nhat05027/BCNN-Verilog/Gowin/cnn_fpga/impl/gwsynthesis/cnn_fpga_syn_resource.html

# Hierarchy Module Resource

MODULE NAME | REG NUMBER | ALU NUMBER | LUT NUMBER | DSP NUMBER | BSRAM NUMBER | SSRAM NUMBER | ROM16 NUMBER
uart_controller (C:/Users/ADMIN/Desktop/HK242/DA1/cnnverilog/src/uart_controller.sv) | 30 | - | 242 | - | - | - | -
|--rpll (C:/Users/ADMIN/Desktop/HK242/DA1/cnnverilog/src/uart_controller.sv) | - | - | - | - | - | - | -
|--receiver (C:/Users/ADMIN/Desktop/HK242/DA1/cnnverilog/src/uart_controller.sv) | 38 | - | 59 | - | - | - | -
|--lcd (C:/Users/ADMIN/Desktop/HK242/DA1/cnnverilog/src/uart_controller.sv) | 60 | - | 120 | 1 | - | - | -
|--lcd_ram (C:/Users/ADMIN/Desktop/HK242/DA1/cnnverilog/src/uart_controller.sv) | - | - | - | - | 1 | - | -
|--cnn_ram (C:/Users/ADMIN/Desktop/HK242/DA1/cnnverilog/src/uart_controller.sv) | - | - | - | - | 1 | - | -
|--dut (C:/Users/ADMIN/Desktop/HK242/DA1/cnnverilog/src/uart_controller.sv) | 87 | 417 | 675 | 5 | - | - | -
|--DP (C:/Users/ADMIN/Desktop/HK242/DA1/cnnverilog/src/cnn.sv) | 16 | 144 | 23 | - | 6 | - | -
|--C (C:/Users/ADMIN/Desktop/HK242/DA1/cnnverilog/src/datapath.sv) | 6 | - | 158 | - | - | - | -
|--[0].F (C:/Users/ADMIN/Desktop/HK242/DA1/cnnverilog/src/conv.sv) | 11 | - | 4 | - | - | 3 | -
|--[1].F (C:/Users/ADMIN/Desktop/HK242/DA1/cnnverilog/src/conv.sv) | 8 | - | 1 | - | - | - | -
|--[2].F (C:/Users/ADMIN/Desktop/HK242/DA1/cnnverilog/src/conv.sv) | 8 | - | 1 | - | - | - | -
|--[3].F (C:/Users/ADMIN/Desktop/HK242/DA1/cnnverilog/src/conv.sv) | 8 | - | 1 | - | - | - | -
|--[4].F (C:/Users/ADMIN/Desktop/HK242/DA1/cnnverilog/src/conv.sv) | 8 | - | 1 | - | - | - | -
|--[5].F (C:/Users/ADMIN/Desktop/HK242/DA1/cnnverilog/src/conv.sv) | 8 | - | 1 | - | - | - | -
|--[6].F (C:/Users/ADMIN/Desktop/HK242/DA1/cnnverilog/src/conv.sv) | 8 | - | 1 | - | - | - | -
|--[7].F (C:/Users/ADMIN/Desktop/HK242/DA1/cnnverilog/src/conv.sv) | 8 | - | 1 | - | - | - | -
|--[8].F (C:/Users/ADMIN/Desktop/HK242/DA1/cnnverilog/src/conv.sv) | 8 | - | 1 | - | - | - | -
|--[9].F (C:/Users/ADMIN/Desktop/HK242/DA1/cnnverilog/src/conv.sv) | 8 | - | 1 | - | - | - | -
|--[10].F (C:/Users/ADMIN/Desktop/HK242/DA1/cnnverilog/src/conv.sv) | 8 | - | 1 | - | - | - | -
|--[11].F (C:/Users/ADMIN/Desktop/HK242/DA1/cnnverilog/src/conv.sv) | 8 | - | 1 | - | - | - | -
|--B (C:/Users/ADMIN/Desktop/HK242/DA1/cnnverilog/src/datapath.sv) | 1 | 12 | - | 1 | - | - | -
|--M (C:/Users/ADMIN/Desktop/HK242/DA1/cnnverilog/src/datapath.sv) | 14 | 12 | 2 | - | - | - | -
|--R (C:/Users/ADMIN/Desktop/HK242/DA1/cnnverilog/src/datapath.sv) | - | - | - | - | 12 | - | -
|--FC (C:/Users/ADMIN/Desktop/HK242/DA1/cnnverilog/src/datapath.sv) | 168 | 861 | 540 | 7 | - | - | -
|--b7s (C:/Users/ADMIN/Desktop/HK242/DA1/cnnverilog/src/uart_controller.sv) | - | - | 7 | - | - | - | -
