nhat05027/BCNN-Verilog/Tensorflow/model_1.png

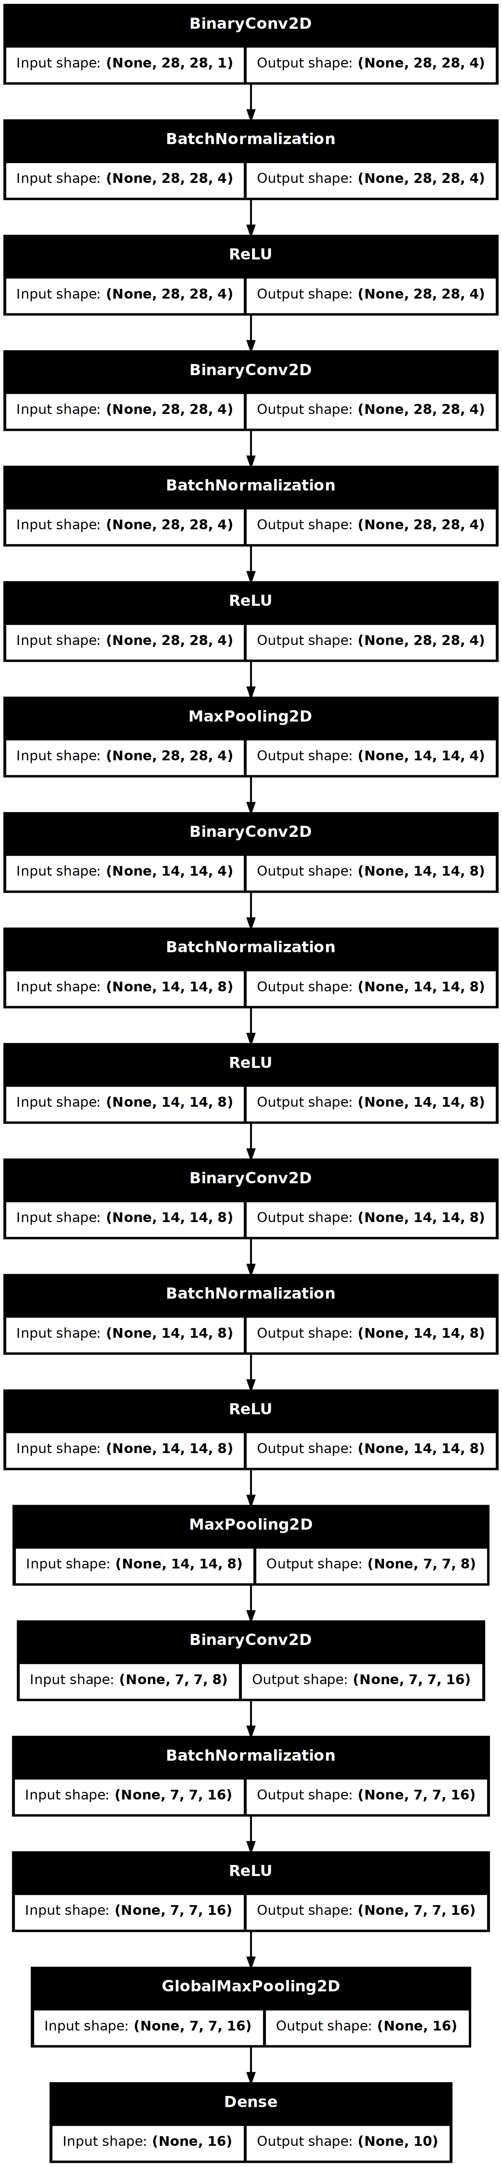
Tensorflow/model_1.png
