nhat05027/BCNN-Verilog/(list of files, cad)

Other CAD files:
Source/sim/work/@s@i@p@o110/verilog.psm
Source/sim/work/@s@i@p@o19/verilog.psm
Source/sim/work/bnorm/verilog.psm
Source/sim/work/bnorm_tb/verilog.psm
Source/sim/work/bsram/verilog.psm
Source/sim/work/cnn/verilog.psm
Source/sim/work/conv/verilog.psm
Source/sim/work/datapath/verilog.psm
Source/sim/work/fullyconnect/verilog.psm
Source/sim/work/maxpool/verilog.psm
Source/sim/work/maxpool_tb/verilog.psm
Source/sim/work/tb_@fully@connect/verilog.psm
Source/sim/work/tb_cnn/verilog.psm
Source/sim/work/tb_cnn_data/verilog.psm
Source/sim/work/tb_conv/verilog.psm
