nhat05027/BCNN-Verilog/Tensorflow/riscv_tf/main.cpp

#include <stdio.h>
#include <math.h>

// ---------------------------------------------------------------
// Model parameters (weights/biases exported from Keras)
// ---------------------------------------------------------------
// Conv2D 4 filters (3x3x1) -> shape [3,3,1,4]
static const float conv1_weights[] = { -0.07325755, 1.1865675, -0.17460105, 0.40934697, 0.0067278566, 0.8636283, 0.45649847, 0.5782181, -0.2517621, 0.88706565, 0.5372558, 0.603698, -0.2393193, -0.22988063, -0.917086, 0.9243598, -0.1709271, 0.16026053, -1.2387735, 0.6723341, -0.2249587, 1.0668899, -0.9474671, 0.26665154, -0.3354636, -0.47381037, 0.75013095, 1.6653285, -0.1717411, -0.0008511407, 0.7554222, 1.1162299, -0.02599886, 0.9655173, 0.03283484, 0.3153005 };
static const float conv1_biases[] = { -0.0057602557, 0.009248344, 0.14225759, 0.0031061384 };

// Conv2D 4 filters (3x3x4) -> shape [3,3,4,4]
static const float conv2_weights[] = { -0.01088712, -0.3036457, 0.24031475, -0.34698504, -0.26682404, -0.22727878, -0.18428035, 0.2874258, 0.28785935, 0.010403978, 0.5203401, 0.25949764, 0.5126956, -0.5555797, -0.055433907, 0.58513504, 0.6083265, 0.6415772, -0.6009929, -0.32115903, -0.4709797, 1.0332346, -0.055764534, 0.38916385, 0.018557593, 0.41868, 0.045105934, 0.23267984, 0.41250557, -0.40582815, -0.99003583, 0.050791334, -0.06867215, 0.27649683, 0.21546951, -0.28690234, -0.024974648, 0.15738049, 0.2401684, 0.059852898, -0.1119299, 0.24527204, 0.6021312, 0.053253673, 0.3388022, -0.68192935, 0.18965793, 0.35157827, 0.25378338, -0.25444534, -0.19876163, 0.84034413, -0.47733316, 0.50577575, -0.5050591, 0.39539972, 0.79705817, -0.3527634, 0.1641575, 0.250387, 0.1342169, -0.37232152, 0.3504775, 0.47050747, 0.23209712, -0.12971093, -0.09909364, 0.16289406, -0.35095435, 0.07611779, -0.31883323, 0.31837082, -0.059359442, 0.24805127, 0.08057558, 0.019344294, -0.16560827, 0.5327667, -0.03475747, -0.587979, 0.72544926, 0.22987206, -0.06600979, 0.20631593, -0.3201445, 0.41457087, 0.56551987, 0.81760734, -0.6246146, 0.08307117, -0.23296995, 0.48730856, 0.762274, 0.55056506, 0.51478106, -0.36040822, -0.123235546, -0.18418932, -0.22301318, -0.1336672, 0.10016488, 0.017201573, 0.2694336, 0.3405063, -0.7011545, 0.56025875, 0.438921, 0.43655512, -0.5791701, 0.11916409, 0.04553071, 0.17359571, 0.6005645, 0.11485608, 0.41269487, 0.1991921, 0.72890055, -0.10148199, -0.4755993, 0.9072527, -0.47777984, 0.41334307, 0.14900841, 0.2068486, 0.027522497, 0.36563176, 0.6453733, -0.31193602 };
static const float conv2_biases[] = { 0.3819936, -0.07001688, 0.12729412, -0.13527243, 0.07212647, -0.25915867, 0.25544053, -0.2796472 };

// Conv2D 8 filters (3x3x4) -> shape [3,3,4,8]
static const float conv3_weights[] = { 0.15287168, -0.20409591, -0.09280203, -0.17846659, -0.17123844, -0.02452941, -0.13050608, 0.045706138, 0.21714623, 0.3463425, -0.22927395, -0.18537723, -0.59825796, 0.03659077, 0.19623262, -0.31443736, -0.09767249, 0.15515976, 0.11915348, 0.120993026, -0.20428105, -0.017163128, 0.067816354, -0.01635299, 0.24587846, -0.10959043, -0.23060824, 0.13133955, 0.24761252, 0.13580404, -0.2694428, 0.07657811, 0.050641842, 0.09968607, -0.07344906, -0.11813574, -0.052198283, 0.027025193, -0.04242616, 0.03897246, -0.13237049, 0.27915382, 0.07203275, 0.0046772277, 0.2833235, 0.12686063, 0.12126272, 0.037548255, 0.10849891, 0.17790574, 0.13273388, -0.19460797, 0.06264373, -0.120539546, -0.105678886, -0.36591157, 0.13751115, -1.3597682e-05, -0.12738647, -0.011708451, 0.24454571, 0.072701596, 0.07909019, -0.06745986, -0.21081485, 0.28860134, 0.37528, -0.10813254, -0.03050478, -0.14402059, 0.10086593, -0.58867216, 0.15834863, 0.201875, -0.13897444, 0.05667091, 0.04708601, 0.05241519, 0.019037655, 0.03038402, 0.5048801, -0.4781108, -0.04544161, 0.25084713, 0.3434982, 0.11335812, -0.82281095, -0.22301137, 0.25825077, -0.1017176, -0.09924755, 0.6630139, -0.5048119, 0.19345064, -0.47907588, -0.007575396, 0.08764215, 0.21433954, 0.3500961, 0.15470448, -0.0028568413, -0.18015556, -0.21324863, 0.16492061, -0.093261145, 0.073492646, 0.06138217, 0.008659468, -0.06976022, 0.03613273, -0.0044700857, 0.17592151, 0.17403379, -0.048351374, -0.31549734, -0.65919447, 0.3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
    int k_size, int out_c,
    int stride, float* output) {
    int out_w = (in_w - k_size) / stride + 1;

    for (int oc = 0; oc < out_c; oc++) {
        for (int y = 0; y < out_w; y++) {
            for (int x = 0; x < out_w; x++) {
                float sum = bias[oc];

                for (int ic = 0; ic < in_c; ic++) {
                    for (int ky = 0; ky < k_size; ky++) {
                        for (int kx = 0; kx < k_size; kx++) {
                            int in_pos = ((y * stride + ky) * in_w + (x * stride + kx)) * in_c + ic;
                            int w_pos = ((ky * k_size + kx) * in_c + ic) * out_c + oc;
                            sum += input[in_pos] * weights[w_pos];
                        }
                    }
                }
                output[(y * out_w + x) * out_c + oc] = sum > 0 ? sum : 0; // ReLU
            }
        }
    }
}

void maxpool2d(const float* input, int in_size, int channels,
    int pool_size, float* output) {
    int out_size = in_size / pool_size;

    for (int c = 0; c < channels; c++) {
        for (int y = 0; y < out_size; y++) {
            for (int x = 0; x < out_size; x++) {
                float max_val = -INFINITY;

                for (int py = 0; py < pool_size; py++) {
                    for (int px = 0; px < pool_size; px++) {
                        int pos = ((y * pool_size + py) * in_size + (x * pool_size + px)) * channels + c;
                        if (input[pos] > max_val) max_val = input[pos];
                    }
                }
                output[(y * out_size + x) * channels + c] = max_val;
            }
        }
    }
}

// ---------------------------------------------------------------
// Inference pipeline
// ---------------------------------------------------------------
float* mnist_inference(const float* input) {
    // Allocate memory buffers (adjust sizes according to your architecture)
    static float buf1[26 * 26 * 4];  // First conv output
    static float buf2[13 * 13 * 4];  // After first maxpool

    static float buf3[12 * 12 * 8];  // Second conv output
    static float buf4[6 * 6 * 8];  // After second maxpool

    static float buf5[4 * 4 * 16];  // Third conv output
    static float buf_global_pool[16];  //After global maxpool
    // ... Add more buffers for intermediate results ...
    static float final_output[10];  // Final classification result

    // Layer 1: Conv2D 4 filters
    conv2d(input, conv1_weights, conv1_biases,
        28, 28, 1,
        3, 4, 1, buf1);

    // Layer 2: MaxPool2D
    maxpool2d(buf1, 26, 4, 2, buf2);

    // Layer 3: Conv2D 8 filters
    conv2d(buf2, conv2_weights, conv2_biases,
        13, 13, 4,
        2, 8, 1, buf3);

    // Layer 4: MaxPool2D
    maxpool2d(buf3, 12, 8, 2, buf4);

    // Layer 5: Conv2D 8 filters
    conv2d(buf4, conv3_weights, conv3_biases,
        6, 6, 8,
        3, 16, 1, buf5);

    // Global Max Pooling (2x2 -> 1x1)
    for (int c = 0; c < 16; c++) {
        float max_val = -INFINITY;
        for (int y = 0; y < 4; y++) {
            for (int x = 0; x < 4; x++) {
                // Calculate position in HWC format
                int pos = (y * 4 + x) * 16 + c;
                if (buf5[pos] > max_val) {
                    max_val = buf5[pos];
                }
            }
        }
        buf_global_pool[c] = max_val;
    }


    // Final dense layer (simplified)
    for (int i = 0; i < 10; i++) {
        final_output[i] = dense_biases[i];
        for (int j = 0; j < 16; j++) {
            final_output[i] += buf_global_pool[j] * dense_weights[j * 10 + i];
        }
    }

    return final_output;
}

// ---------------------------------------------------------------
// Example usage
// ---------------------------------------------------------------
int main() {
    // Load your 28x28 input image (normalized 0-1)
    float input[28 * 28] = { 0, 0, 0, 0, 0, 0, 0, 0, 0, 0, 0, 0, 0, 0, 0, 0, 0, 0, 0, 0, 0, 0, 0, 0, 0, 0, 0, 0, 0, 0, 0, 0, 0, 0, 0, 0, 0, 0, 0, 0, 0, 0, 0, 0, 0, 0, 0, 0, 0, 0, 0, 0, 0, 0, 0, 0, 0, 0, 0, 0, 0, 0, 0, 0, 0, 0, 0, 0, 0, 0, 0, 0, 0, 0, 0, 0, 0, 0, 0, 0, 0, 0, 0, 0, 0, 0, 0, 0, 0, 0, 0, 0, 0, 0, 0, 0, 0, 0, 0, 0, 0, 0, 0, 0, 0, 0, 0, 0, 0, 0, 0, 0, 0, 0, 0, 0, 0, 0, 0, 0, 0, 0, 0, 0, 0, 0, 0, 0, 0, 0, 0, 0, 0, 0, 0, 0, 0, 0, 0, 0, 0, 0, 0, 0, 0, 0, 0, 0, 0, 0, 0, 0, 3, 18, 18, 18, 126, 136, 175, 26, 166, 255, 247, 127, 0, 0, 0, 0, 0, 0, 0, 0, 0, 0, 0, 0, 30, 36, 94, 154, 170, 253, 253, 253, 253, 253, 225, 172, 253, 242, 195, 64, 0, 0, 0, 0, 0, 0, 0, 0, 0, 0, 0, 49, 238, 253, 253, 253, 253, 253, 253, 253, 253, 251, 93, 82, 82, 56, 39, 0, 0, 0, 0, 0, 0, 0, 0, 0, 0, 0, 0, 18, 219, 253, 253, 253, 253, 253, 198, 182, 247, 241, 0, 0, 0, 0, 0, 0, 0, 0, 0, 0, 0, 0, 0, 0, 0, 0, 0, 0, 80, 156, 107, 253, 253, 205, 11, 0, 43, 154, 0, 0, 0, 0, 0, 0, 0, 0, 0, 0, 0, 0, 0, 0, 0, 0, 0, 0, 0, 14, 1, 154, 253, 90, 0, 0, 0, 0, 0, 0, 0, 0, 0, 0, 0, 0, 0, 0, 0, 0, 0, 0, 0, 0, 0, 0, 0, 0, 0, 139, 253, 190, 2, 0, 0, 0, 0, 0, 0, 0, 0, 0, 0, 0, 0, 0, 0, 0, 0, 0, 0, 0, 0, 0, 0, 0, 0, 11, 190, 253, 70, 0, 0, 0, 0, 0, 0, 0, 0, 0, 0, 0, 0, 0, 0, 0, 0, 0, 0, 0, 0, 0, 0, 0, 0, 0, 35, 241, 225, 160, 108, 1, 0, 0, 0, 0, 0, 0, 0, 0, 0, 0, 0, 0, 0, 0, 0, 0, 0, 0, 0, 0, 0, 0, 0, 81, 240, 253, 253, 119, 25, 0, 0, 0, 0, 0, 0, 0, 0, 0, 0, 0, 0, 0, 0, 0, 0, 0, 0, 0, 0, 0, 0, 0, 45, 186, 253, 253, 150, 27, 0, 0, 0, 0, 0, 0, 0, 0, 0, 0, 0, 0, 0, 0, 0, 0, 0, 0, 0, 0, 0, 0, 0, 16, 93, 252, 253, 187, 0, 0, 0, 0, 0, 0, 0, 0, 0, 0, 0, 0, 0, 0, 0, 0, 0, 0, 0, 0, 0, 0, 0, 0, 0, 249, 253, 249, 64, 0, 0, 0, 0, 0, 0, 0, 0, 0, 0, 0, 0, 0, 0, 0, 0, 0, 0, 0, 0, 0, 46, 130, 183, 253, 253, 207, 2, 0, 0, 0, 0, 0, 0, 0, 0, 0, 0, 0, 0, 0, 0, 0, 0, 0, 0, 0, 39, 148, 229, 253, 253, 253, 250, 182, 0, 0, 0, 0, 0, 0, 0, 0, 0, 0, 0, 0, 0, 0, 0, 0, 0, 0, 24, 114, 221, 253, 253, 253, 253, 201, 78, 0, 0, 0, 0, 0, 0, 0, 0, 0, 0, 0, 0, 0, 0, 0, 0, 0, 23, 66, 213, 253, 253, 253, 253, 198, 81, 2, 0, 0, 0, 0, 0, 0, 0, 0, 0, 0, 0, 0, 0, 0, 0, 0, 18, 171, 219, 253, 253, 253, 253, 195, 80, 9, 0, 0, 0, 0, 0, 0, 0, 0, 0, 0, 0, 0, 0, 0, 0, 0, 55, 172, 226, 253, 253, 253, 253, 244, 133, 11, 0, 0, 0, 0, 0, 0, 0, 0, 0, 0, 0, 0, 0, 0, 0, 0, 0, 0, 136, 253, 253, 253, 212, 135, 132, 16, 0, 0, 0, 0, 0, 0, 0, 0, 0, 0, 0, 0, 0, 0, 0, 0, 0, 0, 0, 0, 0, 0, 0, 0, 0, 0, 0, 0, 0, 0, 0, 0, 0, 0, 0, 0, 0, 0, 0, 0, 0, 0, 0, 0, 0, 0, 0, 0, 0, 0, 0, 0, 0, 0, 0, 0, 0, 0, 0, 0, 0, 0, 0, 0, 0, 0, 0, 0, 0, 0, 0, 0, 0, 0, 0, 0, 0, 0, 0, 0, 0, 0, 0, 0, 0, 0, 0, 0, 0, 0, 0, 0, 0, 0, 0, 0, 0, 0, 0, 0 };

    // Run inference
    float* output = mnist_inference(input);

    // Get predicted class
    int pred_class = 0;
    for (int i = 1; i < 10; i++) {
        printf("%f, ", output[i]);
        if (output[i] > output[pred_class]) pred_class = i;
    }
    printf("Predicted digit: %d\n", pred_class);
    
}
