nhat05027/BCNN-Verilog/Tensorflow/riscv_tf/temp.cpp

#include <stdio.h>
#include <math.h>

// ---------------------------------------------------------------
// Model parameters (weights/biases exported from Keras)
// ---------------------------------------------------------------
// Conv2D 4 filters (3x3x1) -> shape [3,3,1,4]
static const float conv1_weights[] = { -0.013006928, 0.052514654, 0.3308295, 0.23587856, 0.37412256, -0.12428157, -0.12785678, 0.092448235, 0.51979434, 0.26796374, 0.11025464, 0.30701604, 0.37487727, 0.33787963, -0.043551754, 0.43335778, 0.50335014, 0.1351254, 0.012763259, 0.09662639, -0.1039135, 0.46803546, -0.027705627, -0.2720974, 0.112422675, 0.16793564, -0.44712543, 0.27267516, 0.4409682, -0.09921773, 0.02049797, -0.10773806, 0.20091721, 0.3523908, -0.35431004, 0.09776787 };
static const float conv1_biases[] = { 0.092024036, 0.049219284, 0.20675494, 0.056861363 };

// Conv2D 4 filters (3x3x4) -> shape [3,3,4,4]
static const float conv2_weights[] = { -0.03487213, 0.32123038, 0.09787129, 0.11164576, -0.014153743, -0.091051176, -0.13975494, 0.31535095, -0.30334726, 0.28391838, 0.040475123, -0.23280929, 0.03983691, -0.12808971, 0.12604314, 0.25124943, 0.34388295, 0.3317762, 0.12612765, 0.01464312, -0.018778212, -0.1768957, 0.24519676, 0.27451187, -0.25662795, 0.31121686, -0.22143047, 0.015658159, 0.4181698, 0.09473117, 0.028627768, -0.06811778, -0.021695698, 0.08795263, -0.40262347, 0.41905823, 0.31008416, -0.10774226, -0.40883714, 0.3534138, -0.12891093, -0.002336803, 0.1604111, -0.4003015, -0.08750545, 0.29693255, 0.16405332, 0.29487893, 0.34203944, -0.052496094, 0.07398583, 0.2617179, 0.35989213, -0.16915406, -0.11791486, 0.13267966, -0.10930654, 0.28677112, -0.06174299, 0.2576202, 0.3538356, -0.12711108, 0.22343071, 0.17548949, 0.29214177, -0.2303775, 0.19812344, 0.1476932, 0.0649545, 0.1299199, -0.13861205, 0.33720562, -0.1978089, 0.062174838, 0.08359506, -0.09319211, -0.06868179, 0.056109723, 0.051784527, -0.11509438, -0.23314118, 0.06956024, -0.14934202, 0.23958743, -0.2086862, -0.20700334, -0.05686912, 0.11978772, 0.19538032, 0.106110334, -0.041990295, -0.121938266, -0.13504978, -0.06699886, -0.08564884, -0.031206343, 0.050539523, -0.28520325, 0.04238145, -0.1741947, 0.17879935, 0.09365681, -0.17976408, -0.15236105, -0.06265621, -0.11857745, -0.17934366, 0.3261815, 0.17790566, 0.19306162, 0.36399212, 0.3139553, -0.32645443, -0.03248266, 0.08423267, 0.28810734, 0.14954121, -0.22070065, 0.018689228, 0.12061099, 0.36053002, -0.14898342, 0.32935396, 0.4152317, 0.014101478, 0.114752114, 0.2057272, 0.07763896, -0.047614463, 0.14869402, -0.48025617, -0.05627416, -0.10785226, -0.14176108, -0.33203578, 0.015088225, 0.07032499, 0.3701881, 0.369519, 0.14896011, 0.039639268, -0.15935409, 0.08316984, -0.031282537 };
static const float conv2_biases[] = { 0.056636304, 0.08686447, 0.040629983, 0.08706406 };

// Conv2D 8 filters (3x3x4) -> shape [3,3,4,8]
static const float conv3_weights[] = { 0.2612895, -0.14293614, -0.24704693, 0.033847593, 0.19759513, -0.04396718, 0.18549931, -0.1497004, 0.12982202, 0.116423376, -0.18914132, 0.10760966, -0.07914929, 0.093477845, -0.23365489, 0.016281577, -0.1461098, -0.07402766, 0.08123549, 0.25366685, 0.17001282, -0.008700933, 0.003976913, -0.24915811, -0.18151626, 0.00448174, -0.16560936, 0.18327191, 0.0071463226, -0.120424815, 0.016090928, 0.26296842, 0.010496771, -0.02070395, 0.2623469, -0.052956752, 0.1774641, -0.103968374, -0.1183773, -0.12690598, 0.047876224, -0.046221074, -0.0226399, 0.023085495, -0.08301618, 0.3137854, -0.29387507, 0.23948911, -0.088251516, 0.11308062, 0.1767525, 0.37037864, -0.07511342, -0.08972957, -0.17750247, 0.11390811, 0.10339316, -0.23381968, 0.17258994, 0.00763402, -0.086173475, 0.019450324, -0.08638137, 0.31775674, -0.15057519, -0.3639849, -0.100649625, 0.08897505, -0.1463464, -0.040527795, -0.07067275, -0.04910255, -0.33613822, 0.3192447, -0.054632228, -0.13693029, -0.11595578, 0.10165867, -0.0039297305, -0.09253458, -0.26760402, -0.33240625, 0.05996953, 0.35524783, -0.03994178, -0.21674383, -0.14852993, 0.02499393, 0.058511507, -0.35265777, 0.02180226, -0.045694184, 0.11271904, -0.12531082, -0.091998816, 0.18603635, -0.03262353, 0.041715756, 0.113738105, 0.32364058, 0.09704796, 0.3100634, -0.043902084, -0.053122465, 0.030745313, 0.12275172, 0.05571297, -0.15235636, 0.118252955, -0.0037045856, -0.15113854, 0.36698437, -0.21310323, -0.38750097, 0.19515179, 0.4439868, -0.20119613, -0.08716594, 0.1726022, -0.016415838, 0.017969918, 0.14463244, 0.28236774, 0.18454227, 0.13245405, 0.33365357, -0.04327907, 0.253196, 0.115944825, -0.19962172, -0.051785897, 0.19030978, 0.063333586, 0.05916197, 0.16020638, -0.0007700811, 0.176794, 0.14070508, -0.003274687, -0.27716884, 0.21242881, 0.23328972, -0.112197, 0.2407089, 0.078630805, -0.094694555, 0.11341124, 0.12945253, 0.12611072, -0.13905123, -0.1765515, -0.36152118, -0.083982766, -0.10522438, 0.27959377, -0.21759935, 0.11155276, 0.14126277, 0.21827503, -0.11877283, -0.03560305, 0.08849318, 0.31847495, 0.046809778, -0.11306629, -0.14031549, 0.13428694, -0.11183573, -0.37343267, 0.03138435, -0.19585647, -0.07406485, -0.3009169, 0.2930223, 0.02760383, -0.08714468, 0.009490647, -0.06659941, -0.16140473, 0.17536466, 0.054466024, -0.228748, -0.15215282, -0.024776159, 0.3152567, -0.03012955, 0.10391613, -0.034441978, 0.17751884, 0.056817446, 0.15839423, -0.0050807735, 0.34237337, 0.27279967, 0.1414174, 0.29738337, 0.06400519, 0.116942234, 0.30402604, 0.078656696, 0.47836512, 0.23755787, 0.06956001, -0.30809015, 0.33029062, 0.12751336, 0.07331243, 0.2389474, 0.13624573, -0.20505783, 0.021944987, -0.011764594, -0.25350064, -0.17069158, -0.080096066, -0.23612234, 0.09744093, 0.30106315, 0.17512439, -0.008958555, -0.035132743, -0.106683746, 0.134053, -0.2802923, 0.17160326, 0.15916516, -0.106084175, -0.07098854, -0.17416376, 0.04433102, 0.30991444, -0.20798525, 0.37005863, 0.008114886, -0.25576726, -0.10958251, -0.03414804, 0.30850774, 0.037057854, -0.068740785, 0.117033675, -0.19558042, -0.37149322, -0.12987018, -0.20401436, -0.29945377, -0.12557787, 0.076518506, -0.044494063, 0.35119563, 0.1754594, -0.14734258, 0.34107068, 0.26432976, 0.32849163, -0.09761697, -0.19158034, 0.15190794, -0.13427886, 0.04402215, -0.10011488, -0.21733113, 0.2616226, -0.0105885165, -0.12322944, 0.1164218, 0.15766118, -0.25336882, -0.22318561, 0.2444845, 0.15432414, 0.03242836, 0.085035846, -0.13011165, -0.03675828, -0.2192443, 0.029497616, -0.19624525, 0.07665505, 0.09337494, 0.30471018, 0.2894279, 0.043306828, 0.013714123, 0.26521307, -0.06792191, -0.13822058, 0.03792165 };
static const float conv3_biases[] = { 0.029675534, 0.041953787, 0.01833088, -0.03400233, -0.002593667, 0.08668897, 0.06841709, 0.023940621 };

// Conv2D 8 filters (3x3x8) -> shape [3,3,8,8]
static const float conv4_weights[] = { -0.23589014, -0.020541733, 0.10350853, 0.13808794, -0.059882373, -0.024842924, -0.13328475, -0.18991731, 0.19606479, -0.13584784, 0.020229807, 0.21101129, 0.25521147, -0.2842782, -0.17822817, 0.05010315, -0.33061302, 0.022949597, -0.14742008, 0.13071658, -0.16107738, -0.18878435, 0.2056569, 0.14353645, 0.01016005, -0.11161154, -0.037395198, 0.047122464, -0.10202803, 0.08802496, 0.2054864, 0.037611697, -0.22599523, 0.16236503, 0.013623393, -0.060001273, 0.008367365, 0.19283509, -0.10932796, -0.0021964426, -0.1690602, 0.105359055, -0.062400058, 0.13485166, -0.07621775, 0.117278, 0.015717654, -0.14879748, 0.02953327, 0.031922296, 0.16781262, 0.12170966, -0.042742092, -0.093739524, -0.007996974, 0.27396393, -0.056977917, 0.10105277, 0.07354779, -0.004687494, 0.04254482, 0.29749238, -0.10613141, -0.14872558, -0.07226764, 0.12226293, 0.09087598, 0.042881906, 0.24335451, 0.094930984, -0.059704438, 0.013959043, -0.06497552, -0.1209734, 0.0748143, 0.28093946, 0.21731997, -0.110857904, 0.016627893, 0.120894805, -0.266727, -0.10863977, 0.091318525, 0.02481527, 0.047420762, -0.19654416, 0.13875468, 0.16281722, -0.16620861, -0.15848364, 0.14850226, -0.20739073, -0.29606226, 0.032893855, -0.0061664456, 0.17315221, 0.009510098, 0.038136102, -0.023197671, 0.12913398, 0.06731654, 0.034791686, 0.08356099, -0.16365302, -0.040708087, 0.13368341, -0.1417715, 0.19206305, -0.03346289, -0.23598798, -0.045028623, 0.06546528, 0.0063244696, 0.06680143, 0.08071279,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
// ---------------------------------------------------------------
void conv2d(const float* input, const float* weights, const float* bias,
    int in_w, int in_h, int in_c,
    int k_size, int out_c,
    int stride, float* output) {
    int out_w = (in_w - k_size) / stride + 1;

    for (int oc = 0; oc < out_c; oc++) {
        for (int y = 0; y < out_w; y++) {
            for (int x = 0; x < out_w; x++) {
                float sum = bias[oc];

                for (int ic = 0; ic < in_c; ic++) {
                    for (int ky = 0; ky < k_size; ky++) {
                        for (int kx = 0; kx < k_size; kx++) {
                            int in_pos = ((y * stride + ky) * in_w + (x * stride + kx)) * in_c + ic;
                            int w_pos = ((ky * k_size + kx) * in_c + ic) * out_c + oc;
                            sum += input[in_pos] * weights[w_pos];
                        }
                    }
                }
                output[(y * out_w + x) * out_c + oc] = sum > 0 ? sum : 0; // ReLU
            }
        }
    }
}

void maxpool2d(const float* input, int in_size, int channels,
    int pool_size, float* output) {
    int out_size = in_size / pool_size;

    for (int c = 0; c < channels; c++) {
        for (int y = 0; y < out_size; y++) {
            for (int x = 0; x < out_size; x++) {
                float max_val = -INFINITY;

                for (int py = 0; py < pool_size; py++) {
                    for (int px = 0; px < pool_size; px++) {
                        int pos = ((y * pool_size + py) * in_size + (x * pool_size + px)) * channels + c;
                        if (input[pos] > max_val) max_val = input[pos];
                    }
                }
                output[(y * out_size + x) * channels + c] = max_val;
            }
        }
    }
}

// ---------------------------------------------------------------
// Inference pipeline
// ---------------------------------------------------------------
float* mnist_inference(const float* input) {
    // Allocate memory buffers (adjust sizes according to your architecture)
    static float buf1[26 * 26 * 4];  // First conv output
    static float buf2[24 * 24 * 4];  // Second conv output
    static float buf3[12 * 12 * 4];  // After first maxpool

    static float buf4[10 * 10 * 8];  // Third conv output
    static float buf5[8 * 8 * 8];  // Fourth conv output
    static float buf6[4 * 4 * 8];  // After second maxpool

    static float buf7[2 * 2 * 16];  // Fifth conv output
    static float buf_global_pool[16];  //After global maxpool
    // ... Add more buffers for intermediate results ...
    static float final_output[10];  // Final classification result

    // Layer 1: Conv2D 4 filters
    conv2d(input, conv1_weights, conv1_biases,
        28, 28, 1,
        3, 4, 1, buf1);

    // Layer 2: Conv2D 4 filters
    conv2d(buf1, conv2_weights, conv2_biases,
        26, 26, 4,
        3, 4, 1, buf2);

    // Layer 3: MaxPool2D
    maxpool2d(buf2, 24, 4, 2, buf3);

    // Layer 4: Conv2D 8 filters
    conv2d(buf3, conv3_weights, conv3_biases,
        12, 12, 4,
        3, 8, 1, buf4);

    // Layer 5: Conv2D 8 filters
    conv2d(buf4, conv4_weights, conv4_biases,
        10, 10, 8,
        3, 8, 1, buf5);

    // Layer 6: MaxPool2D
    maxpool2d(buf5, 8, 8, 2, buf6);

    // Layer 7: Conv2D 8 filters
    conv2d(buf6, conv5_weights, conv5_biases,
        4, 4, 8,
        3, 16, 1, buf7);

    // Global Max Pooling (2x2 -> 1x1)
    for (int c = 0; c < 16; c++) {
        float max_val = -INFINITY;
        for (int y = 0; y < 2; y++) {
            for (int x = 0; x < 2; x++) {
                // Calculate position in HWC format
                int pos = (y * 2 + x) * 16 + c;
                if (buf7[pos] > max_val) {
                    max_val = buf7[pos];
                }
            }
        }
        buf_global_pool[c] = max_val;
    }


    // Final dense layer (simplified)
    for (int i = 0; i < 10; i++) {
        final_output[i] = dense_biases[i];
        for (int j = 0; j < 16; j++) {
            final_output[i] += buf_global_pool[j] * dense_weights[j * 10 + i];
        }
    }

    return final_output;
}

// ---------------------------------------------------------------
// Example usage
// ---------------------------------------------------------------
int main() {
    // Load your 28x28 input image (normalized 0-1)
    float input[28 * 28] = { 0.0, 0.0, 0.0, 0.0, 0.0, 0.0, 0.0, 0.0, 0.0, 0.0, 0.0, 0.0, 0.0, 0.0, 0.0, 0.0, 0.0, 0.0, 0.0, 0.0, 0.0, 0.0, 0.0, 0.0, 0.0, 0.0, 0.0, 0.0, 0.0, 0.0, 0.0, 0.0, 0.0, 0.0, 0.0, 0.0, 0.0, 0.0, 0.0, 0.0, 0.0, 0.0, 0.0, 0.0, 0.0, 0.0, 0.0, 0.0, 0.0, 0.0, 0.0, 0.0, 0.0, 0.0, 0.0, 0.0, 0.0, 0.0, 0.0, 0.0, 0.0, 0.0, 0.0, 0.0, 0.0, 0.0, 0.0, 0.0, 0.0, 0.0, 0.0, 0.0, 0.0, 0.0, 0.0, 0.0, 0.0, 0.0, 0.0, 0.0, 0.0, 0.0, 0.0, 0.0, 0.0, 0.0, 0.0, 0.0, 0.0, 0.0, 0.0, 0.0, 0.0, 0.0, 0.0, 0.0, 0.0, 0.0, 0.0, 0.0, 0.0, 0.0, 0.0, 0.0, 0.0, 0.0, 0.0, 0.0, 0.0, 0.0, 0.0, 0.0, 0.0, 0.0, 0.0, 0.0, 0.0, 0.0, 0.0, 0.0, 0.0, 0.0, 0.0, 0.0, 0.0, 0.0, 0.0, 0.19921875, 0.62109375, 0.98828125, 0.62109375, 0.1953125, 0.0, 0.0, 0.0, 0.0, 0.0, 0.0, 0.0, 0.0, 0.0, 0.0, 0.0, 0.0, 0.0, 0.0, 0.0, 0.0, 0.0, 0.0, 0.0, 0.0, 0.0, 0.0, 0.1875, 0.9296875, 0.984375, 0.984375, 0.984375, 0.92578125, 0.0, 0.0, 0.0, 0.0, 0.0, 0.0, 0.0, 0.0, 0.0, 0.0, 0.0, 0.0, 0.0, 0.0, 0.0, 0.0, 0.0, 0.0, 0.0, 0.0, 0.0, 0.2109375, 0.88671875, 0.98828125, 0.984375, 0.93359375, 0.91015625, 0.984375, 0.22265625, 0.0234375, 0.0, 0.0, 0.0, 0.0, 0.0, 0.0, 0.0, 0.0, 0.0, 0.0, 0.0, 0.0, 0.0, 0.0, 0.0, 0.0, 0.0, 0.0390625, 0.234375, 0.875, 0.984375, 0.98828125, 0.984375, 0.7890625, 0.328125, 0.984375, 0.98828125, 0.4765625, 0.0, 0.0, 0.0, 0.0, 0.0, 0.0, 0.0, 0.0, 0.0, 0.0, 0.0, 0.0, 0.0, 0.0, 0.0, 0.0, 0.0, 0.63671875, 0.984375, 0.984375, 0.984375, 0.98828125, 0.984375, 0.984375, 0.375, 0.73828125, 0.98828125, 0.65234375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

    // Run inference
    float* output = mnist_inference(input);

    // Get predicted class
    int pred_class = 0;
    for (int i = 1; i < 10; i++) {
        if (output[i] > output[pred_class]) pred_class = i;
    }
    printf("Predicted digit: %d\n", pred_class);
    
}
